taifur20/Edge-Bird/README.md

# Edge-Bird
This design is a step toward environmental conservation<br><br>
*Field deployment of the Edge-Bird.*
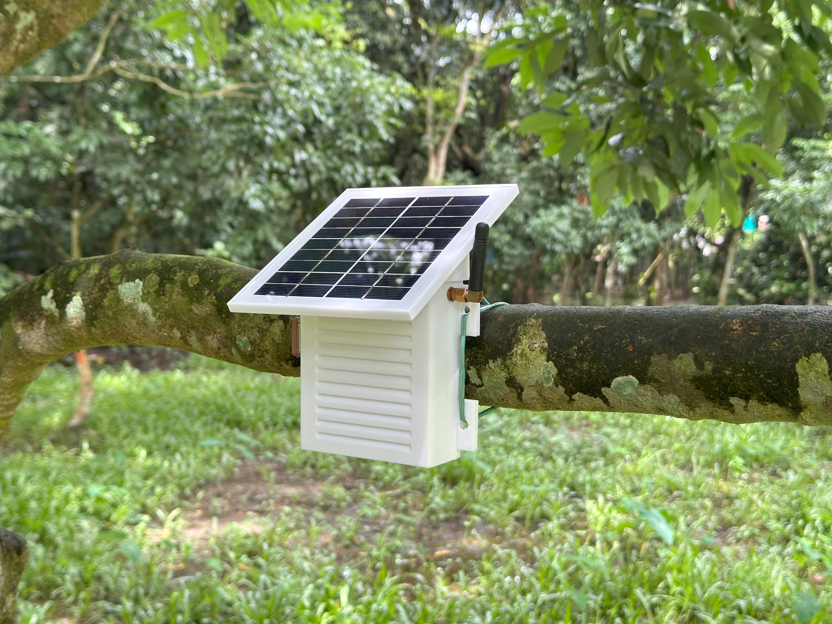
[picture p1: deployment_img1.jpg]
Deployment of the Edge-Bird

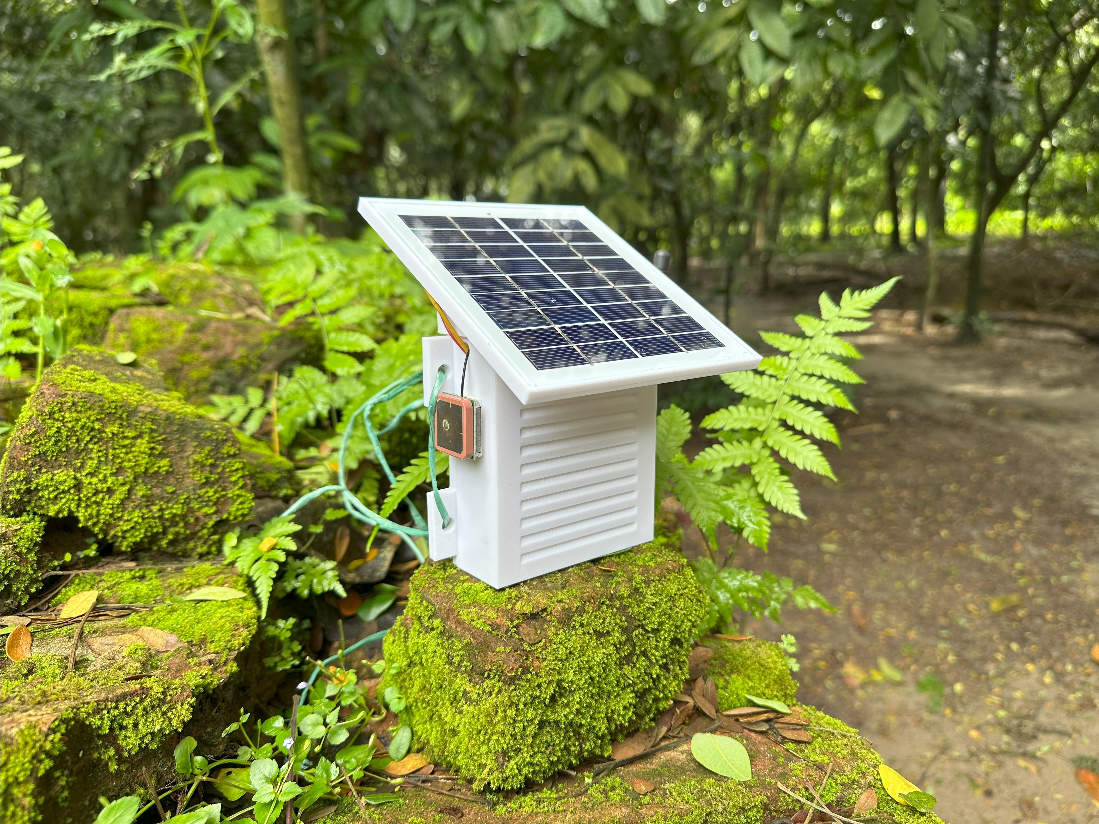
[picture p2: deployment_img2.jpg]
Deployment of the Edge-Bird

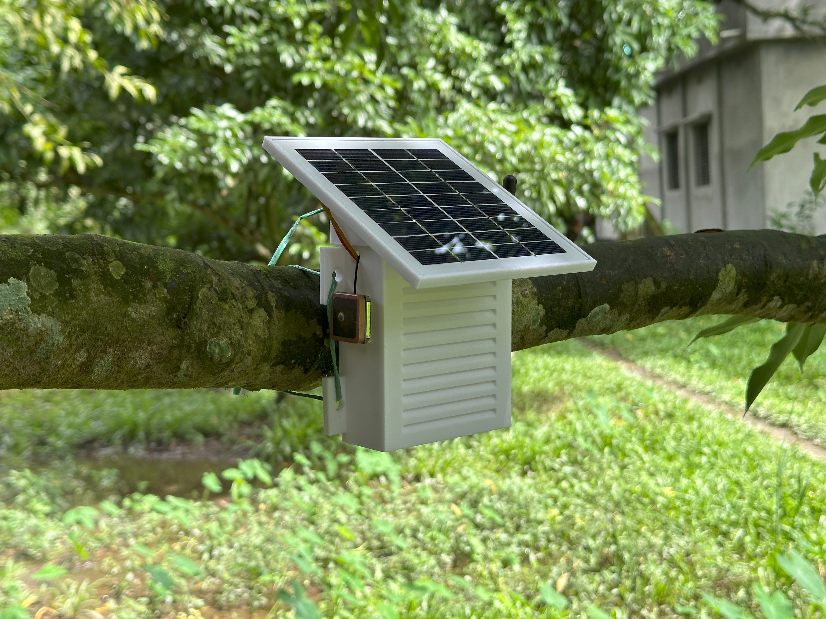
[picture p3: deployment_img3.jpg]
Deployment of the Edge-Bird
