taifur20/Edge-Bird/3D Files/panel_mount.jpg

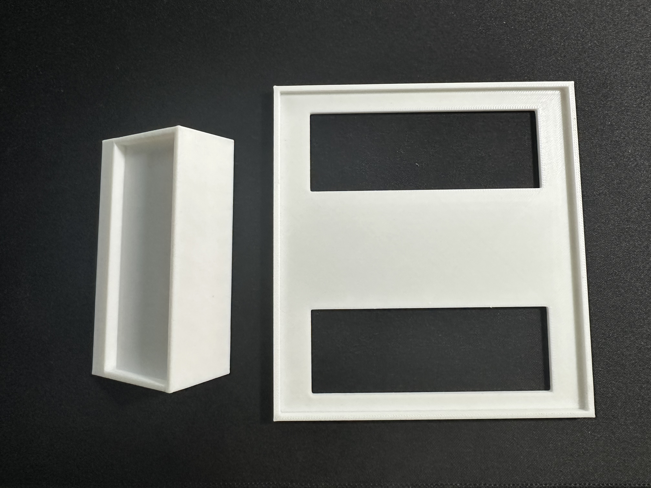
3D Files/panel_mount.jpg
