taifur20/Edge-Bird/full_inference_with_sd_logging/serial_monitor_data.jpg

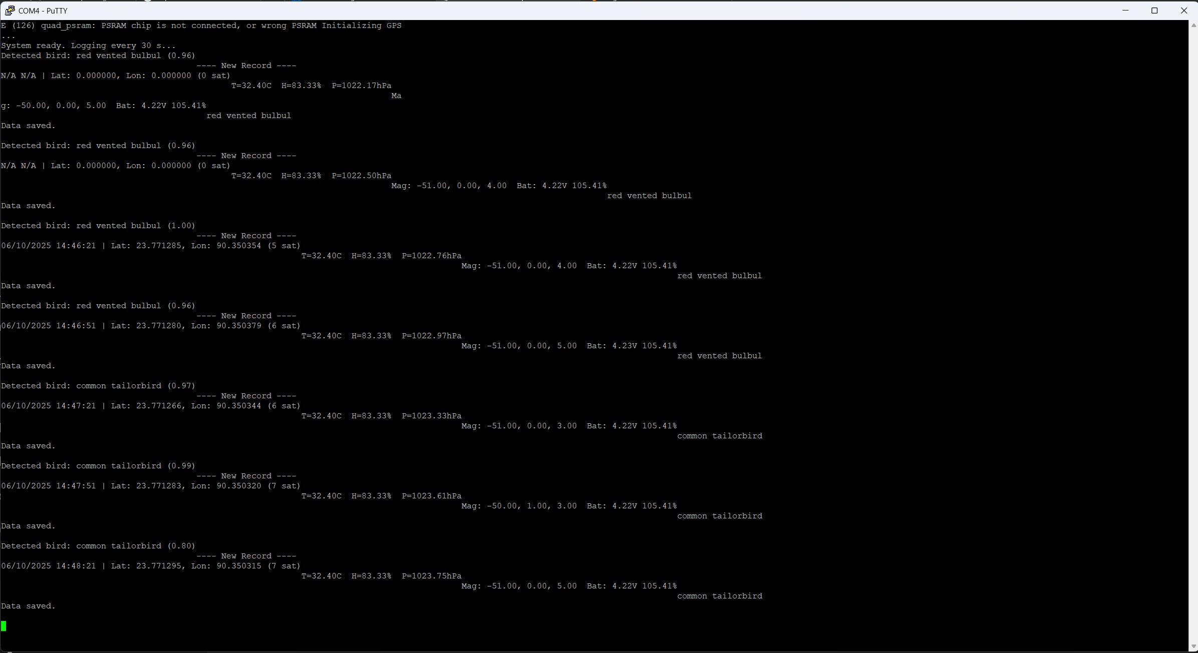
full_inference_with_sd_logging/serial_monitor_data.jpg
