taifur20/Edge-Bird/hardware/2d-view.png

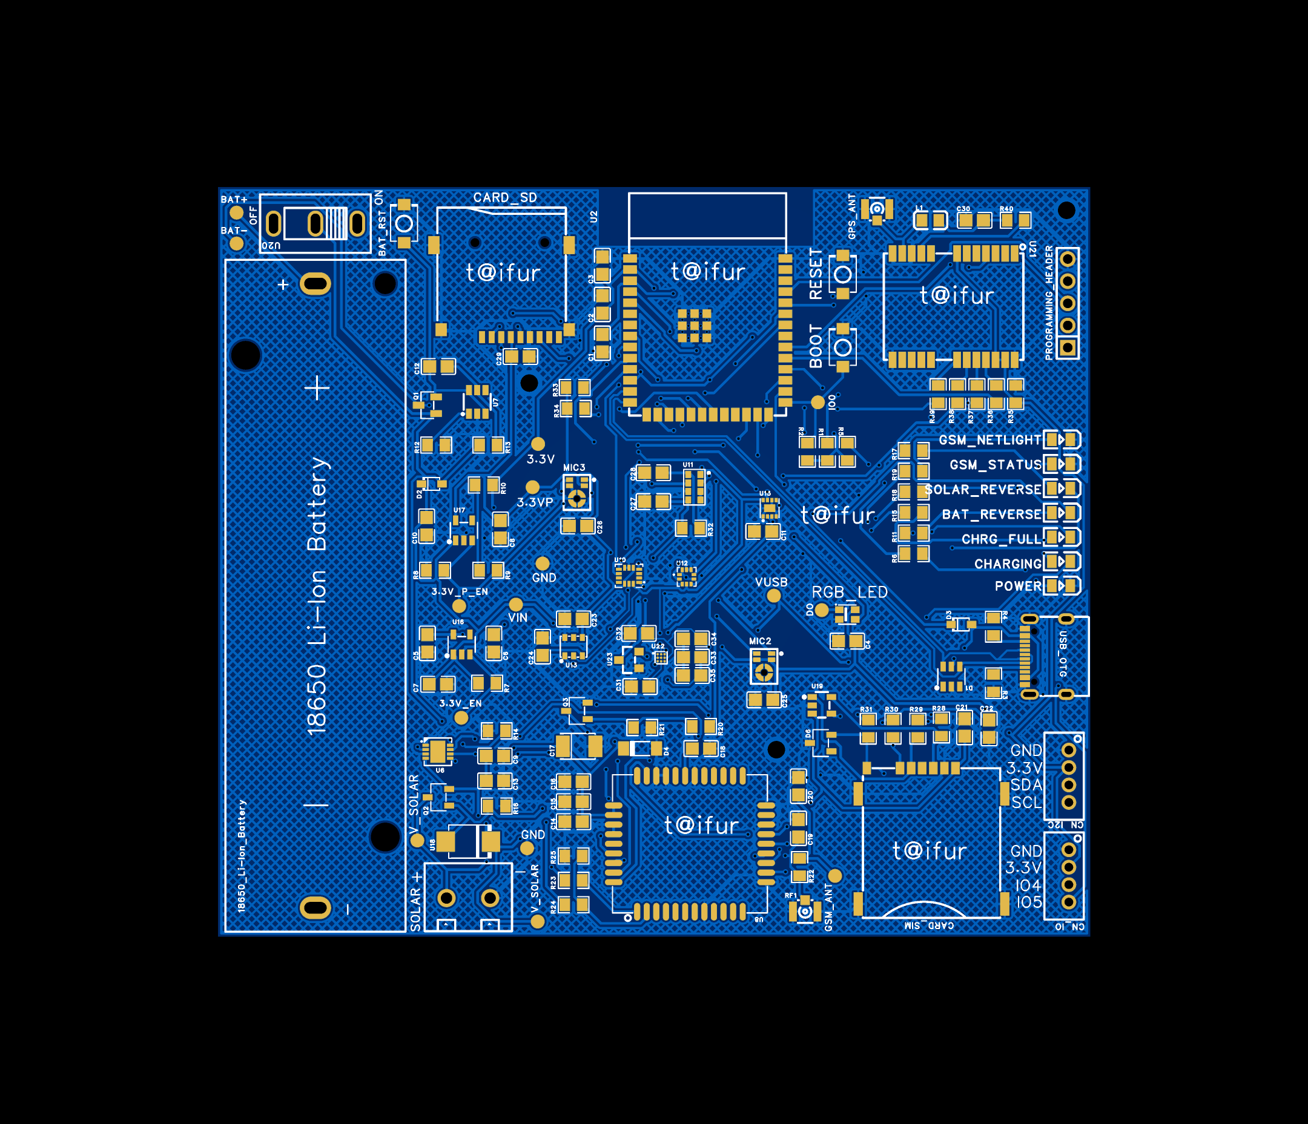
hardware/2d-view.png
