taifur20/Edge-Bird/hardware/3d-view bottom.png

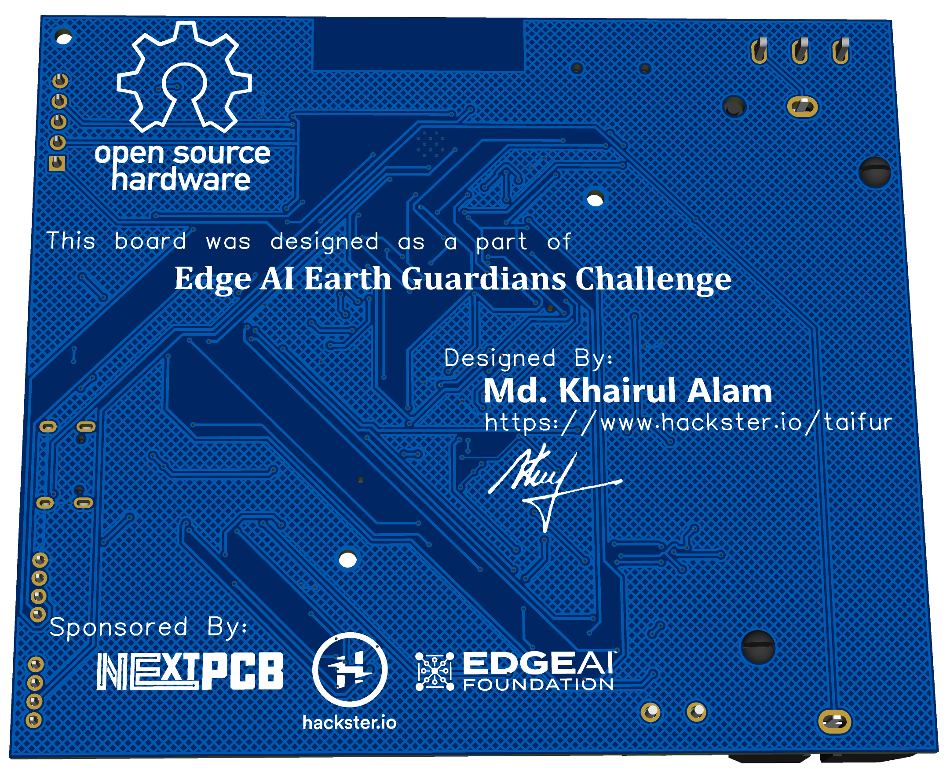
hardware/3d-view bottom.png
