taifur20/Edge-Bird/hardware/3d-view-top.png

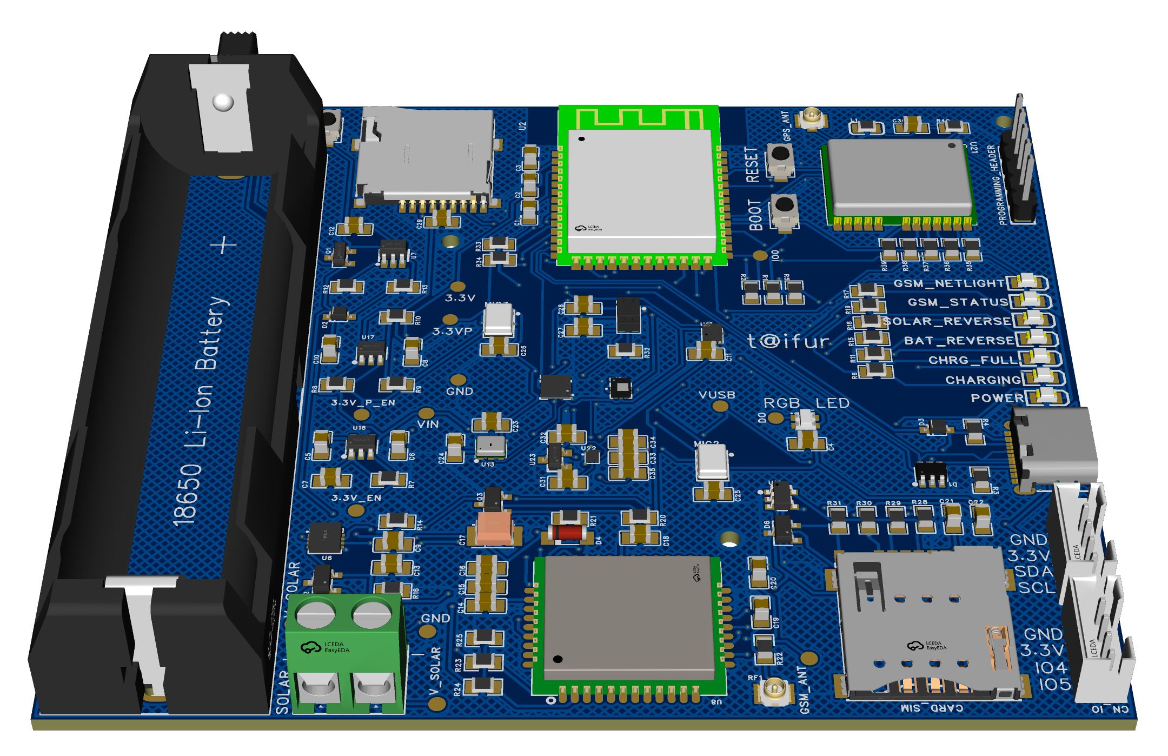
hardware/3d-view-top.png
