taifur20/Edge-Bird/hardware/board_in_hand.jpg

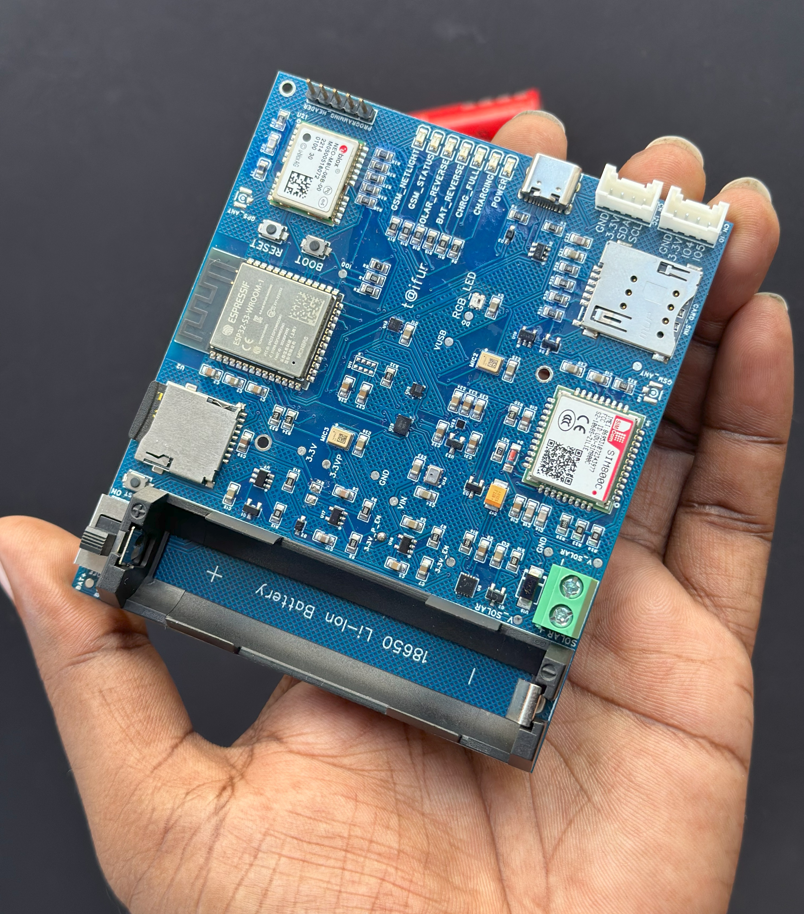
hardware/board_in_hand.jpg
