taifur20/Edge-Bird/sample code/gps_sample/gps-data.jpg

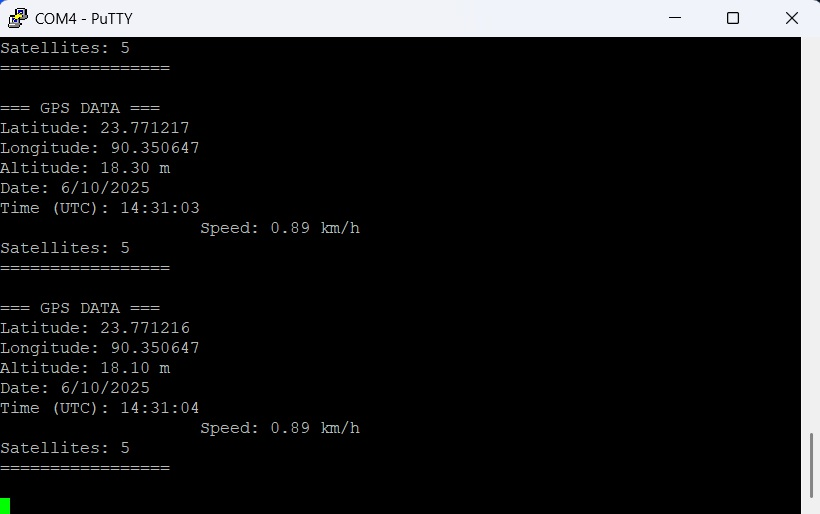
sample code/gps_sample/gps-data.jpg
