taifur20/Edge-Bird/hardware/BOM_Details.xlsx

BOM File: |  | BOMBoard1PCB120250813BE94345AA11 |  |  |  |  |  |  | Order ID： | B-E94345AA1 |  |  |  | Quote Time: | 2025/08/18 13:44:17
Purchase Quantity： |  | 1 pcs |  |  |  |  |  |  | BOM Total ($)： | 97.97
Inquiry |  |  |  |  |  |  |  |  | HQNextPCB-Quotation
S/N | Designator* | Quantity* | Manufacturer Part Number* | Manufacturer | Package /Footprint | Description | Procurement Type | Customer Note | Quote MPN | Quote Brand | Package /Footprint | Plan Qty | Overage Amount | Quote Qty | Unit Price($) | Subtotal($) | Lead Time | Question from HQ NextPCB | Customer Reply
1 | 3.3V_EN,3.3V_P_EN,BAT+,BAT-,DO,GSM_ANT,IO0,V_SOLAR | 8 |  |  | Test-Point-0.5mm |  | DNP |  |  |  |  | 8 | 0 | 8 | 0 | 0
2 | 18650_Li-Ion_Battery | 1 | BH-18650-A6AJ003 | MYOUNG(美阳) | BAT-TH_BH-18650-A5BJ003 |  |  |  | BH-18650-A6AJ003 | MYOUNG(美阳) |  | 1 | 1 | 2 | 1.28968 | 2.58 | 4-7 Days
3 | BAT_REVERSE,CHARGING,GSM_NETLIGHT,GSM_STATUS,SOLAR_REVERSE | 5 | NCD0805R1 | 国星光电 | LED0805-R-RD |  |  |  | NCD0805R1 | NATIONSTAR | 0805 | 5 | 40 | 50 | 0.01025 | 0.51 | In Stock
4 | BAT_RST,BOOT,RESET | 3 | TS-1088-AR02016 | XUNPU(讯普) | SW-SMD_L3.9-W3.0-P4.45 |  |  |  | TS-1088-AR02016 | XUNPU | SW2_4X2.9MM_SM | 3 | 5 | 10 | 0.03846 | 0.38 | In Stock
5 | C1,C5 | 2 | CL21B105KOFNNNE | SAMSUNG(三星) | C0805 | 1uF |  |  | CL21B105KOFNNNE | Samsung | 0805 | 2 | 40 | 50 | 0.00931 | 0.47 | In Stock
6 | C2 | 1 | CC0805KKX5R5BB475 | YAGEO(国巨) | C0805 | 4.7uF |  |  | CC0805KKX5R5BB475 | Yageo | 0805 | 1 | 15 | 16 | 0.08507 | 1.36 | 4-7 Days
7 | C3 | 1 | CL21A226MQQNNNE | SAMSUNG(三星) | C0805 | 22uF |  |  | CL21A226MQQNNNE | Samsung | 0805 | 1 | 40 | 41 | 0.0096 | 0.39 | In Stock
8 | C4,C6,C11,C12,C13,C23,C24,C25,C26 | 9 | CC0805KRX7R5BB104 | YAGEO(国巨) | C0805 | 100nF |  |  | CC0805KRX7R5BB104 | YAGEO | 0805 | 9 | 15 | 24 | 0.08139 | 1.95 | 7-18 Days
9 | C7,C10 | 2 | CL21B225KOFNNNE | SAMSUNG(三星) | C0805 | 2.2uF |  |  | CL21B225KOFNNNE | Samsung | 0805 | 2 | 40 | 42 | 0.01837 | 0.77 | In Stock
10 | C8 | 1 | CL21A106KPFNNNE | SAMSUNG(三星) | C0805 | 10uF |  |  | CL21A106KPFNNNE | Samsung | 0805 | 1 | 40 | 41 | 0.00664 | 0.27 | In Stock
11 | C9 | 1 | CL21A106KOQNNNE | SAMSUNG(三星) | C0805 | 10uF |  |  | CL21A106KOQNNNE | Samsung | 0805 | 1 | 40 | 50 | 0.00687 | 0.34 | In Stock
12 | C14 | 1 | 0805CG100J500NT | FH(风华) | C0805 | 10pF |  |  | 0805CG100J500NT | FH | 0805 | 1 | 40 | 50 | 0.00451 | 0.23 | In Stock
13 | C15 | 1 | 0805CG330J500NT | FH(风华) | C0805 | 33pF |  |  | 0805CG330J500NT | FH | 0805 | 1 | 40 | 50 | 0.00459 | 0.23 | In Stock
14 | C16,C27,C28 | 3 | CL21B105KBFNNNE | SAMSUNG(三星) | C0805 | 1uF |  |  | CL21B105KBFNNNE | Samsung | 0805 | 3 | 40 | 43 | 0.00723 | 0.31 | In Stock
15 | C17 | 1 | TAJB107K006RNJ | Kyocera AVX | CASE-B_3528 | 100uF |  |  | TAJB107K006RNJ | AVX | B3528-21 | 1 | 3 | 5 | 0.1577 | 0.79 | In Stock
16 | C18 | 1 | CL21A475KAQNNNE | SAMSUNG(三星) | C0805 | 4.7uF |  |  | CL21A475KAQNNNE | Samsung | 0805 | 1 | 40 | 41 | 0.00905 | 0.37 | In Stock
17 | C19,C20,C21 | 3 | CC0805KRX7R9BB104 | YAGEO(国巨) | C0805 | 100nF |  |  | CC0805KRX7R9BB104 | Yageo | 0805 | 3 | 40 | 50 | 0.00314 | 0.16 | In Stock
18 | C22 | 1 | CL21C220JBANNNC | SAMSUNG(三星) | C0805 | 22pF |  |  | CL21C220JBANNNC | Samsung | 0805 | 1 | 40 | 50 | 0.00866 | 0.43 | In Stock
19 | C29 | 1 | CL21A106KAYNNNE | SAMSUNG(三星) | C0805 | 10uF |  |  | CL21A106KAYNNNE | Samsung | 0805 | 1 | 40 | 50 | 0.0083 | 0.42 | In Stock
20 | C30 | 1 | CC0805JRNPO9BN470 | YAGEO(国巨) | C0805 | 47pF |  |  | CC0805JRNPO9BN470 | Yageo | 0805 | 1 | 40 | 50 | 0.00559 | 0.28 | In Stock
21 | C31,C32,C33 | 3 | CL21B225KAFNNNE | SAMSUNG(三星) | C0805 | 2.2uF |  |  | CL21B225KAFNNNE | Samsung | 0805 | 3 | 40 | 43 | 0.0095 | 0.41 | In Stock
22 | C34,C35 | 2 | CL21B104KCFNNNE | SAMSUNG(三星) | C0805 | 100nF |  |  | CL21B104KCFNNNE | Samsung | 0805 | 2 | 40 | 42 | 0.00442 | 0.19 | In Stock
23 | CARD_SD | 1 | TF-01A | 韩国韩荣 | TF-SMD_TF-01A |  |  |  | TF-01A | Yuandi | SMD | 1 | 10 | 11 | 0.08689 | 0.96 | In Stock
24 | CARD_SIM | 1 | C7092-03 | MUP(德海威) | SIM-SMD_C7092-03 |  |  |  | C7092-03 | MUP(德海威) | SMD | 1 | 1 | 2 | 0.71782 | 1.44 | 4-7 Days
25 | CHRG_FULL,POWER | 2 | NCD0805G1 | 国星光电 | LED0805-R-RD |  |  |  | NCD0805G1 | NATIONSTAR | 0805 | 2 | 40 | 42 | 0.01957 | 0.82 | In Stock
26 | CN_I2C,CN_IO | 2 | B4B-PH-K-S(LF)(SN) | JST | CONN-TH_B4B-PH-K-S |  | DNP |  |  |  |  | 2 | 0 | 2 | 0 | 0
27 | D1 | 1 | DT1042-04SO-7 | DIODES(美台) | SOT-26_L3.0-W1.6-P0.95-LS2.8-BL |  |  |  | DT1042-04SO-7 | DIODES | SOT23-6 | 1 | 10 | 11 | 0.05801 | 0.64 | In Stock
28 | D2,D3 | 2 | BAT60A | Slkor(萨科微) | SOD-323_L1.8-W1.3-LS2.5-RD |  |  |  | BAT60A | Slkor(萨科微) | SOD-323 | 2 | 30 | 32 | 0.04131 | 1.32 | 4-7 Days
29 | D4 | 1 | ZMM5V1PF-M | ST(先科) | LL-34_L3.5-W1.5-R-RD |  |  |  | ZMM5V1PF-M | ST(先科) | LL-34 | 1 | 15 | 50 | 0.01481 | 0.74 | In Stock
30 | D6 | 1 | ESDA6V1L | BORN(伯恩半导体) | SOT-23-3_L2.9-W1.6-P1.90-LS2.8-BR |  |  |  | ESDA6V1L | BORN(伯恩半导体) | SOT-23 | 1 | 15 | 16 | 0.01283 | 0.21 | In Stock
31 | GPS_ANT,RF1 | 2 | U.FL-R-SMT(01) | HRS(广濑) | ANT-SMD_UFL-R-SMT01 |  |  |  | U.FL-R-SMT(01) | HRS(广濑) | RF-CONN-2.6X2.6MM_SM | 2 | 1 | 3 | 1.5886 | 4.77 | 3-5 Days
32 | L1 | 1 | BLM21PG300SN1D | muRata(村田) | L0805 |  |  |  | BLM21PG300SN1D | Murata | 0805 | 1 | 40 | 50 | 0.01528 | 0.76 | In Stock
33 | MIC2,MIC3 | 2 | IM69D130V01 | Infineon(英飞凌) | MIC-SMD_5P-L4.0-W3.0-P0.70-TR_IM69D130V01 |  |  |  | IM69D130V01 | Infineon |  | 2 | 1 | 3 | 4.04 | 12.12 | 7-18 Days
34 | PROGRAMMING_HEADER | 1 | PROGRAMMING | XFCN(兴飞) | HDR-TH_5P-P2.54-V-M |  | DNP |  |  |  |  | 1 | 0 | 1 | 0 | 0
35 | Q1 | 1 | AO3400 | ALJ(龙晶微) | SOT-23-3_L2.9-W1.3-P1.90-LS2.4-BR |  |  |  | AO3400 | ALJ(龙晶微) | SOT-23 | 1 | 15 | 20 | 0.01822 | 0.36 | In Stock
36 | Q2 | 1 | SI2301 | KUU | SOT-23-3_L2.9-W1.6-P1.90-LS2.8-BR |  |  |  | SI2301 | KUU | SOT-23 | 1 | 15 | 50 | 0.01101 | 0.55 | In Stock
37 | Q3 | 1 | BC848C | Hottech(合科泰) | SOT-23-3_L2.9-W1.6-P1.90-LS2.8-BR |  |  |  | BC848C | Hottech(合科泰) | SOT-23 | 1 | 15 | 24 | 0.0099 | 0.24 | In Stock
38 | R1,R2,R9,R16 | 4 | 0805W8F1002T5E | UNI-ROYAL(厚声) | R0805 | 10kΩ |  |  | 0805W8F1002T5E | Uniohm | 0805 | 4 | 40 | 100 | 0.00106 | 0.11 | In Stock
39 | R3,R4 | 2 | 0805W8F5101T5E | UNI-ROYAL(厚声) | R0805 | 5.1kΩ |  |  | 0805W8F5101T5E | Uniohm | 0805 | 2 | 40 | 100 | 0.00116 | 0.12 | In Stock
40 | R5,R10 | 2 | 0805W8F0000T5E | UNI-ROYAL(厚声) | R0805 | 0Ω |  |  | 0805W8F0000T5E | Uniohm | 0805 | 2 | 40 | 100 | 0.00117 | 0.12 | In Stock
41 | R6,R15,R20,R31,R33,R34 | 6 | 0805W8F4701T5E | UNI-ROYAL(厚声) | R0805 | 4.7kΩ |  |  | 0805W8F4701T5E | Uniohm | 0805 | 6 | 40 | 100 | 0.00109 | 0.11 | In Stock
42 | R7,R8,R35 | 3 | 0805W8F1003T5E | UNI-ROYAL(厚声) | R0805 | 100kΩ |  |  | 0805W8F1003T5E | Uniohm | 0805 | 3 | 40 | 100 | 0.00109 | 0.11 | In Stock
43 | R11,R12,R17,R18,R19,R23,R24 | 7 | 0805W8F1001T5E | UNI-ROYAL(厚声) | R0805 | 1kΩ |  |  | 0805W8F1001T5E | Uniohm | 0805 | 7 | 40 | 100 | 0.00158 | 0.16 | In Stock
44 | R13 | 1 | 0805W8F1000T5E | UNI-ROYAL(厚声) | R0805 | 100Ω |  |  | 0805W8F1000T5E | Uniohm | 0805 | 1 | 40 | 100 | 0.00168 | 0.17 | In Stock
45 | R14 | 1 | 0805W8F2001T5E | UNI-ROYAL(厚声) | R0805 | 2kΩ |  |  | 0805W8F2001T5E | Uniohm | 0805 | 1 | 40 | 100 | 0.00168 | 0.17 | In Stock
46 | R21 | 1 | FRC0805J473 TS | FOJAN(富捷) | R0805 | 47kΩ |  |  | FRC0805J473 TS | FOJAN | 0805 | 1 | 40 | 100 | 0.00082 | 0.08 | In Stock
47 | R22 | 1 | 0805W8F1503T5E | UNI-ROYAL(厚声) | R0805 | 150kΩ |  |  | 0805W8F1503T5E | Uniohm | 0805 | 1 | 40 | 100 | 0.00173 | 0.17 | In Stock
48 | R25 | 1 | 0805W8F5601T5E | UNI-ROYAL(厚声) | R0805 | 5.6kΩ |  |  | 0805W8F5601T5E | Uniohm | 0805 | 1 | 40 | 100 | 0.00173 | 0.17 | In Stock
49 | R28,R29,R30 | 3 | 0805W8F510JT5E | UNI-ROYAL(厚声) | R0805 | 51Ω |  |  | 0805W8F510JT5E | Uniohm | 0805 | 3 | 40 | 100 | 0.00177 | 0.18 | In Stock
50 | R32 | 1 | 0805W8F220JT5E | UNI-ROYAL(厚声) | R0805 | 22Ω |  |  | 0805W8F220JT5E | Uniohm | 0805 | 1 | 40 | 100 | 0.00177 | 0.18 | In Stock
51 | R36,R37,R38,R39 | 4 | 0805W8F330JT5E | UNI-ROYAL(厚声) | R0805 | 33Ω |  |  | 0805W8F330JT5E | Uniohm | 0805 | 4 | 40 | 100 | 0.00173 | 0.17 | In Stock
52 | R40 | 1 | 0805W8F100JT5E | UNI-ROYAL(厚声) | R0805_NEW | 10Ω |  |  | 0805W8F100JT5E | Uniohm | 0805 | 1 | 40 | 100 | 0.00105 | 0.11 | In Stock
53 | RGB_LED | 1 | WS2812B-2020 | worldsemi | LED-SMD_4P-L2.0-W2.0-TL_WS2812B-2020 |  |  |  | WS2812B-2020 | WORLDsemi | LED_2.2X2MM_SM | 1 | 10 | 11 | 0.06423 | 0.71 | In Stock
54 | SOLAR | 1 | WJ126V-5.0-2P | KANGNEX(康奈克斯电气) | CONN-TH_WJ126V-5.0-2P |  |  |  | WJ126V-5.0-2P | Kangnex | TERMINAL_10X7.8MM_TM | 1 | 5 | 6 | 0.06154 | 0.37 | In Stock
55 | U2 | 1 | ESP32-S3-WROOM-1-N8 | ESPRESSIF(乐鑫) | WIFIM-SMD_ESP32-S3-WROOM-1-N8 | 2.4GHz |  |  | ESP32-S3-WROOM-1-N8 | Espressif | MODULE-38P_18X25.5MM_SM | 1 | 0 | 1 | 3.89756 | 3.9 | In Stock
56 | U6 | 1 | CN3165 | CONSONANCE(上海如韵) | DFN-8_L3.0-W3.0-P0.50-BL-EP |  |  |  | CN3165 | CONSONANCE(上海如韵) | DFN8_3.1X3.1MM | 1 | 3 | 4 | 0.31543 | 1.26 | 4-7 Days
57 | U7 | 1 | DW06D/J | FM(富满) | SOT-23-6_L2.9-W1.6-P0.95-LS2.8-BR |  |  |  | DW06D/J | FM(富满) | SOT23-6 | 1 | 10 | 11 | 0.05798 | 0.64 | 4-7 Days
58 | U8 | 1 | SIM800C | SIMCOM(芯讯通无线科技) | GSM-SMD_42P-L17.6-W15.7-P1.10-TL |  |  |  | SIM800C | SIMCOM(芯讯通无线科技) | MODULE-17.6×15.7MM_SM | 1 | 0 | 1 | 7.60363 | 7.6 | 4-7 Days
59 | U10 | 1 | BMI270 | Bosch(博世) | LGA-14_L3.0-W2.5-P0.50-BR |  |  |  | BMI270 | Bosch | LGA14_3X2.5MM | 1 | 0 | 1 | 1.00806 | 1.01 | In Stock
60 | U11 | 1 | APDS-9960 | Broadcom(博通) | SENSORS-SMD_APDS-9960 |  | DNP |  |  |  |  | 1 | 0 | 1 | 0 | 0
61 | U12 | 1 | LPS22HBTR | ST(意法半导体) | HLGA-10L_LPS22HBTR |  |  |  | LPS22HBTR | ST | HLGA-10L_2X2MM | 1 | 0 | 1 | 3.0771 | 3.08 | In Stock
62 | U13 | 1 | HS3003 | RENESAS(瑞萨)/IDT | LGA-6_L3.0-W2.4-P1.00-BL |  |  |  | HS3003 | RENESAS | LGA6_3X2.4MM | 1 | 0 | 1 | 1.96525 | 1.97 | 4-7 Days
63 | U15 | 1 | MAX17048G+T10 | ADI(亚德诺)/MAXIM(美信) | TDFN-8_L2.0-W2.0-P0.50-BL-EP1.2 |  |  |  | MAX17048G+T10 | ADI | WFDFN8_EP | 1 | 0 | 1 | 3.66174 | 3.66 | In Stock
64 | U16,U17 | 2 | RT9080-33GJ5 | RICHTEK(立锜) | TSOT-23-5_L2.9-W1.6-P0.95-LS2.8-BL |  |  |  | RT9080-33GJ5 | Richtek | TSOT23-5 | 2 | 5 | 7 | 0.09781 | 0.68 | In Stock
65 | U18 | 1 | SK34 | CJ(江苏长电/长晶) | SMB_L4.3-W3.6-LS5.4-RD |  |  |  | SK34 | CJ(江苏长电/长晶) | SMA(DO-214AC) | 1 | 5 | 20 | 0.02528 | 0.51 | In Stock
66 | U19 | 1 | ESDA6V1SC5 | ST(意法半导体) | SOT-23-5_L2.9-W1.6-P0.95-LS2.8-BR |  |  |  | ESDA6V1SC5 | ST(意法半导体) | SC-74A | 1 | 5 | 6 | 0.2078 | 1.25 | 4-7 Days
67 | U20 | 1 | SS12D10G5 | SHOU HAN(首韩) | SW-TH_SHOU-HAN_SS12D10G4 |  |  |  | SS12D10G5 | SHOU HAN(首韩) | SW3_12.7X6.6MM_TM | 1 | 3 | 4 | 0.1474 | 0.59 | 4-7 Days
68 | U21 | 1 | NEO-M8U-06B | U-BLOX | GPSM-SMD_24P-L16.0-W12.2-P1.10-TL |  |  |  | NEO-M8U-06B | U-BLOX | SMD24模块 | 1 | 0 | 1 | 27.02976 | 27.03 | 4-7 Days
69 | U22 | 1 | BMM350 | Bosch(博世) | WLCSP-9_L1.3-W1.3-R3-C3-P0.40-TL |  |  |  | BMM350 | Bosch(博世) | WLCSP9 | 1 | 0 | 1 | 2.48414 | 2.48 | 4-7 Days
70 | U23 | 1 | ME6206A18XG | MICRONE(南京微盟) | SOT-23_L2.9-W1.3-P1.90-LS2.4-BR |  |  |  | ME6206A18XG | MICRONE(南京微盟) | SOT-23 | 1 | 15 | 20 | 0.03933 | 0.79 | 4-7 Days
71 | USB_OTG | 1 | TYPE-C 16PIN 2MD(073) | SHOU HAN(首韩) | USB-C-SMD_TYPE-C-6PIN-2MD-073 |  |  |  | TYPE-C 16PIN 2MD(073) | SHOU HAN | USB16-TYPEC_8.94X7.35MM_SM | 1 | 10 | 11 | 0.04923 | 0.54 | In Stock
