taifur20/Edge-Bird/3D Files/Bird-Edge-top.stl

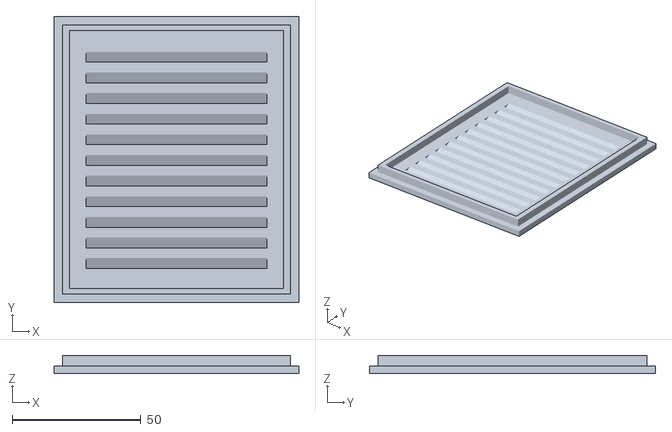
[picture p12: CAD file, 2025-10-01]
3D Files/Bird-Edge-top.stl
95.0 x 111.0 x 7.00
