taifur20/Edge-Bird/3D Files/Bird-Edge-base.stl

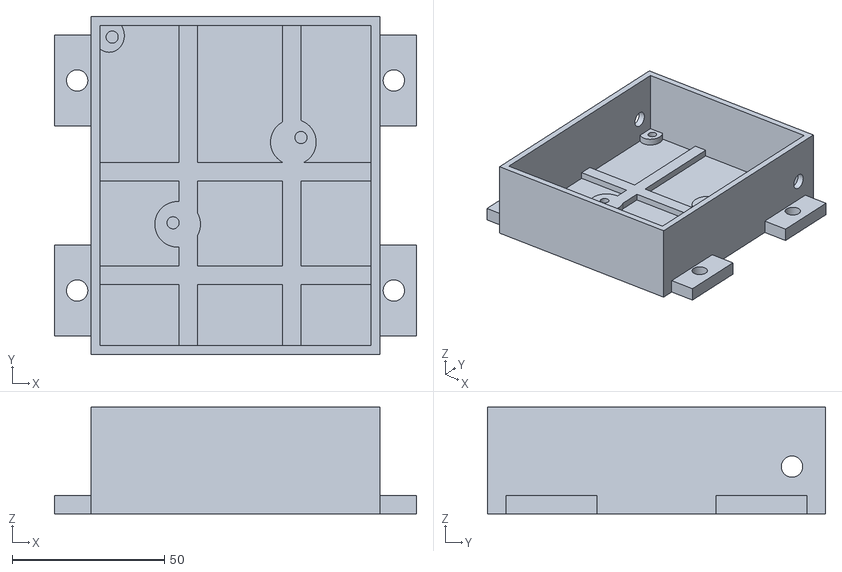
[picture p13: CAD file, 2025-10-01]
3D Files/Bird-Edge-base.stl
119.0 x 111.0 x 35.0
