taifur20/Edge-Bird/3D Files/solar_panel_base.stl

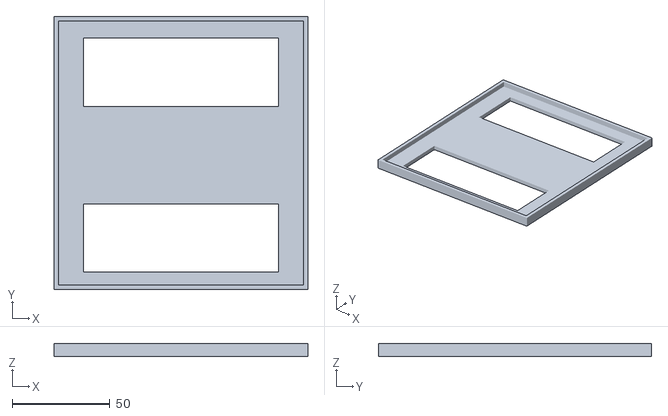
[picture p14: CAD file, 2025-10-01]
3D Files/solar_panel_base.stl
130.0 x 140.0 x 6.50
