taifur20/Edge-Bird/3D Files/panel_angle.stl

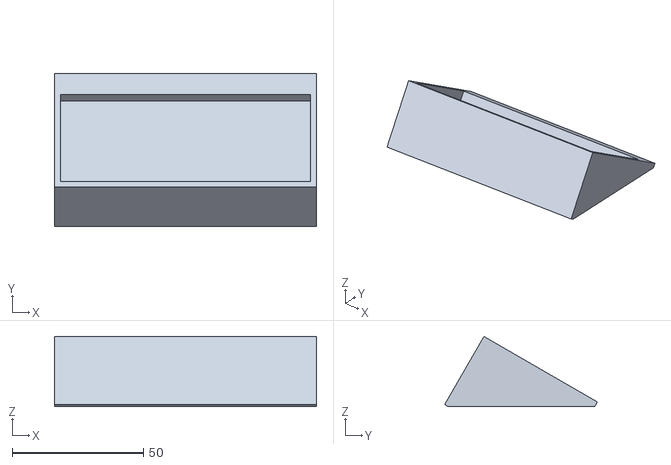
[picture p15: CAD file, 2025-10-01]
3D Files/panel_angle.stl
100.0 x 58.3 x 26.7
