taifur20/Edge-Bird/3D Files/simple_assembly.jpg

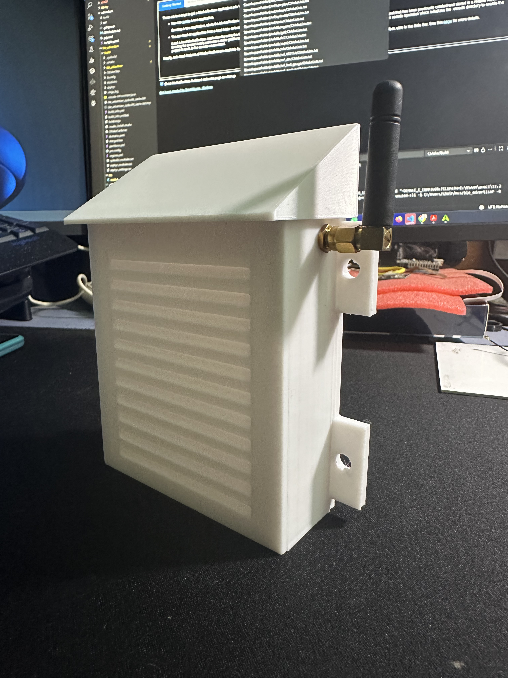
3D Files/simple_assembly.jpg
