taifur20/Edge-Bird/hardware/bird_edge_schematic.pdf

IO0 27 IO35 28 IO36 29 IO37 30 IO38 31 IO39 32 IO40 33 IO41 34 IO42 35 RXD0 36 TXD0 37 IO2 38 IO1 39 GND 40

ESP32 S3 WROOM-1 | USB OTG/PROGRAMMING

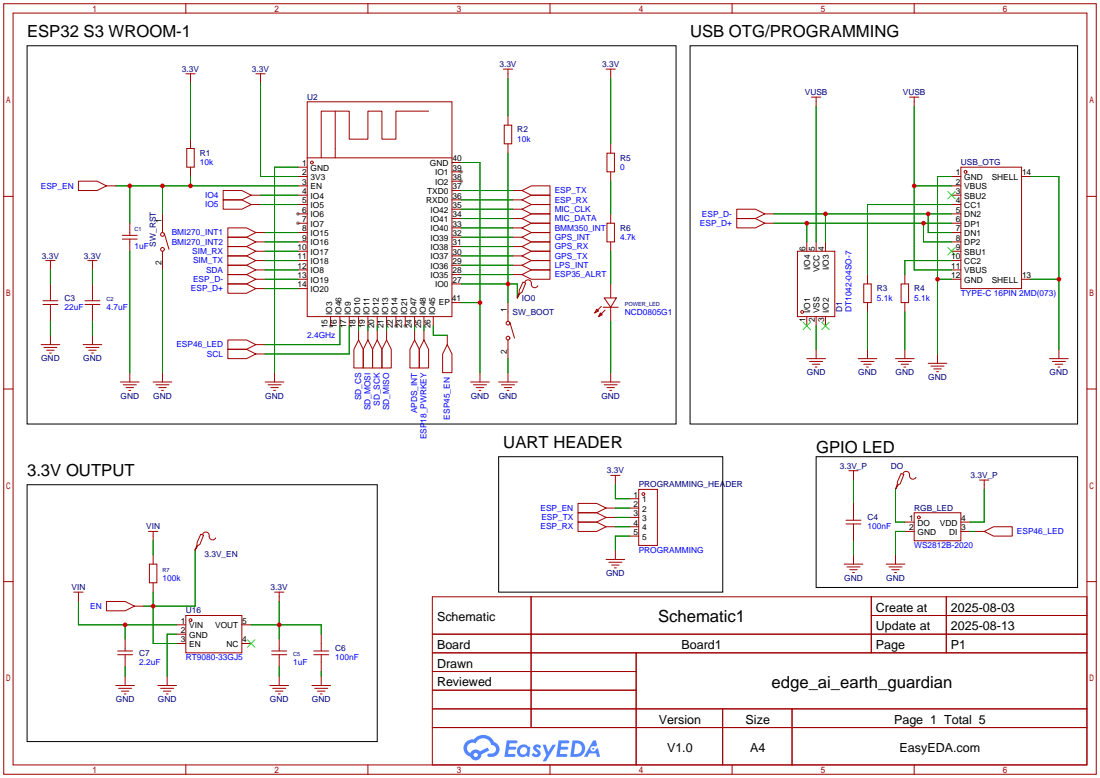
[picture p17: page 1]

Schematic | Schematic1 | Create at | 2025-08-03

Update at | 2025-08-13

Board | Board1 | Page | P1
Drawn | | edge_ai_earth_guardian
Reviewed

Version | Size | Page 1 Total 5
V1.0 | A4 | EasyEDA.com

# Fuel Gauge

# VOLTAGE SUPPLY FOR IO DEVICES

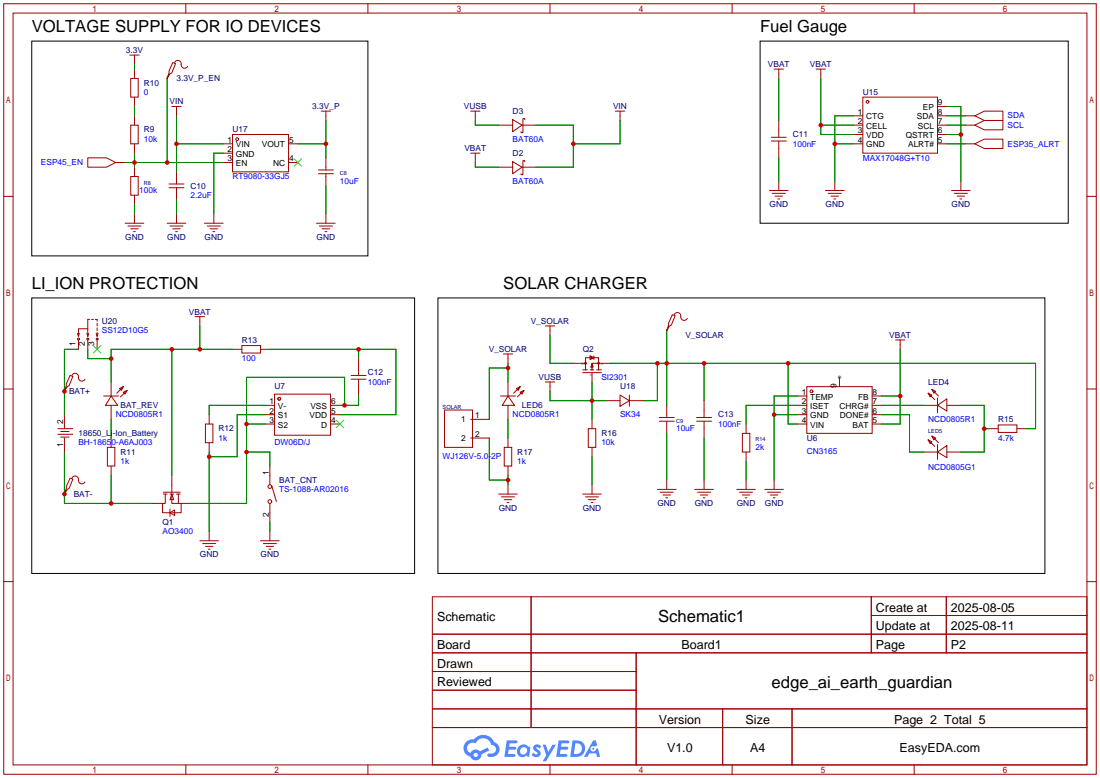
[picture p18: page 2]

Schematic | Schematic1 | Create at | 2025-08-05

Update at | 2025-08-11

Board | Board1 | Page | P2
Drawn | | edge_ai_earth_guardian
Reviewed

MICROPHONE | AMBIENT LIGHT, PROXIMITY | PRESSURE

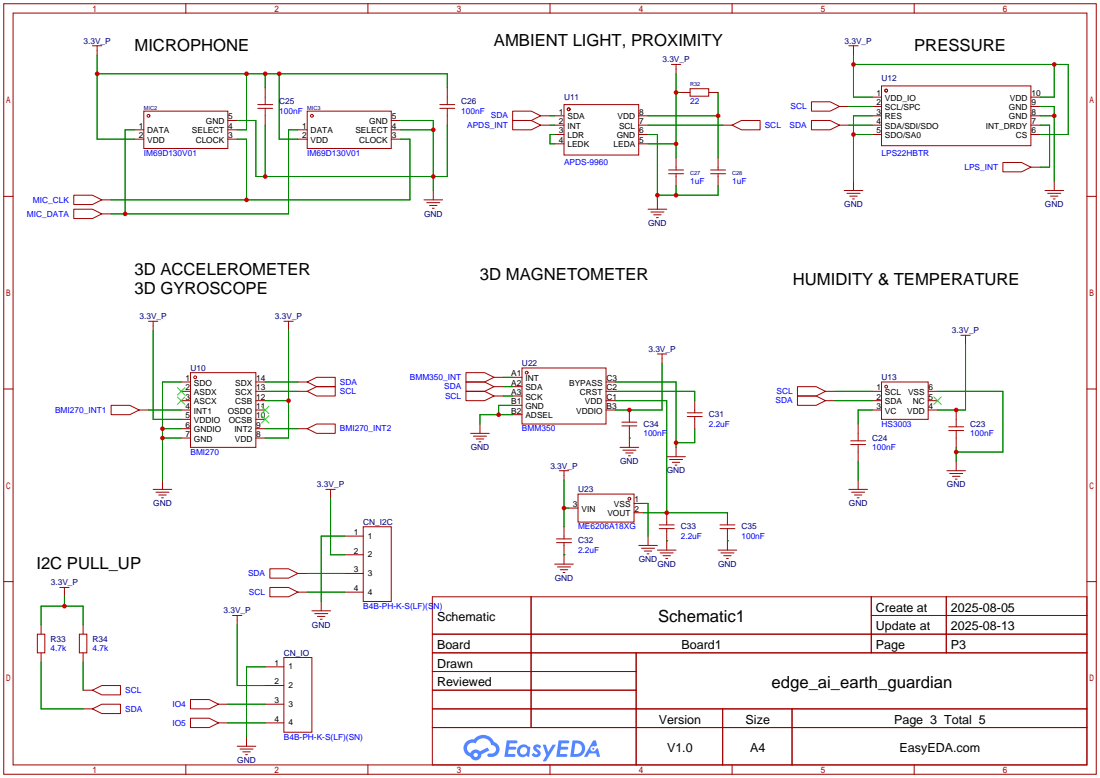
[picture p19: page 3]

ADSEL B2 GND B1 SCK A3 SDA A2 INT A1

OCSB 10 OSDO 11 CSB 12 SCX 13 SDX 14

Schematic | Schematic1 | Create at | 2025-08-05

Update at | 2025-08-13

Board | Board1 | Page | P3
Drawn | | edge_ai_earth_guardian
Reviewed

# SIM800C GSM

# SIM CONNECTOR

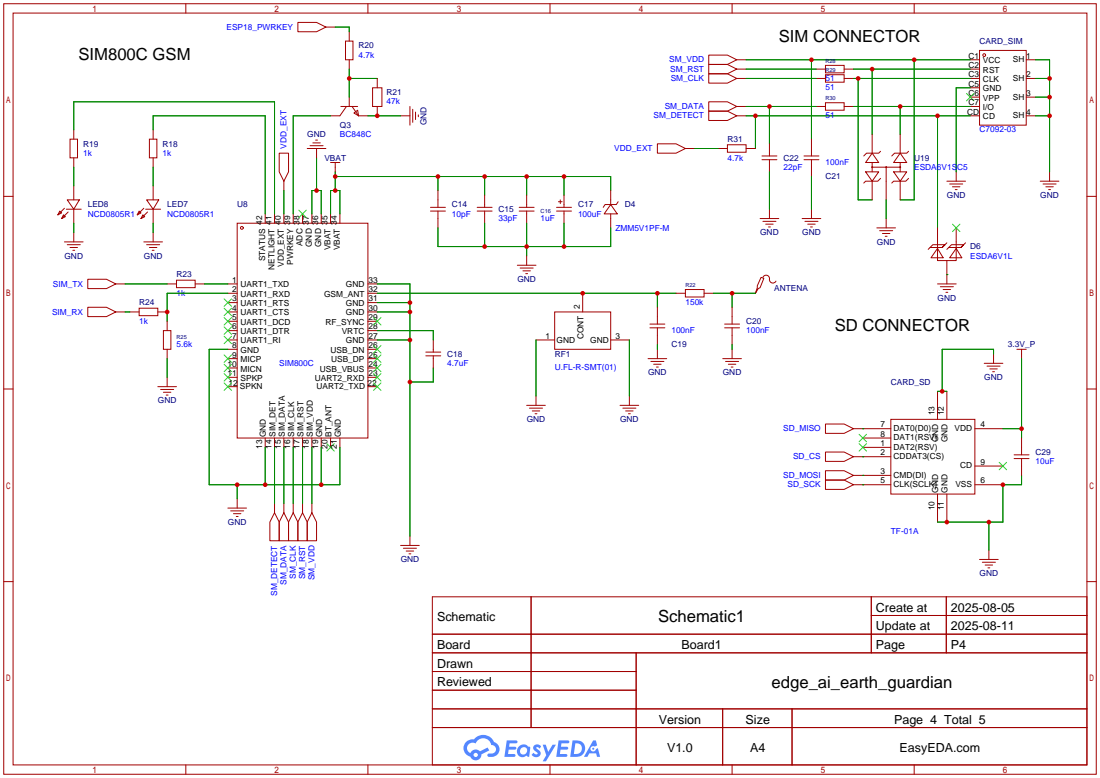
[picture p20: page 4]

CARD_SIM
VPP C6 GND C5 CLK C3 RST C2 VCC C1

UART2_RXD 23 USB_VBUS 24 USB_DP 25 USB_DN 26 GND 27 VRTC 28 RF_SYNC 29 GND 30 GND 31 GSM_ANT 32 GND 33 VBAT 34 VBAT 35 GND ³⁶

Schematic | Schematic1 | Create at | 2025-08-05

Update at | 2025-08-11

Board | Board1 | Page | P4
Drawn | | edge_ai_earth_guardian
Reviewed

# GPS Module Connection

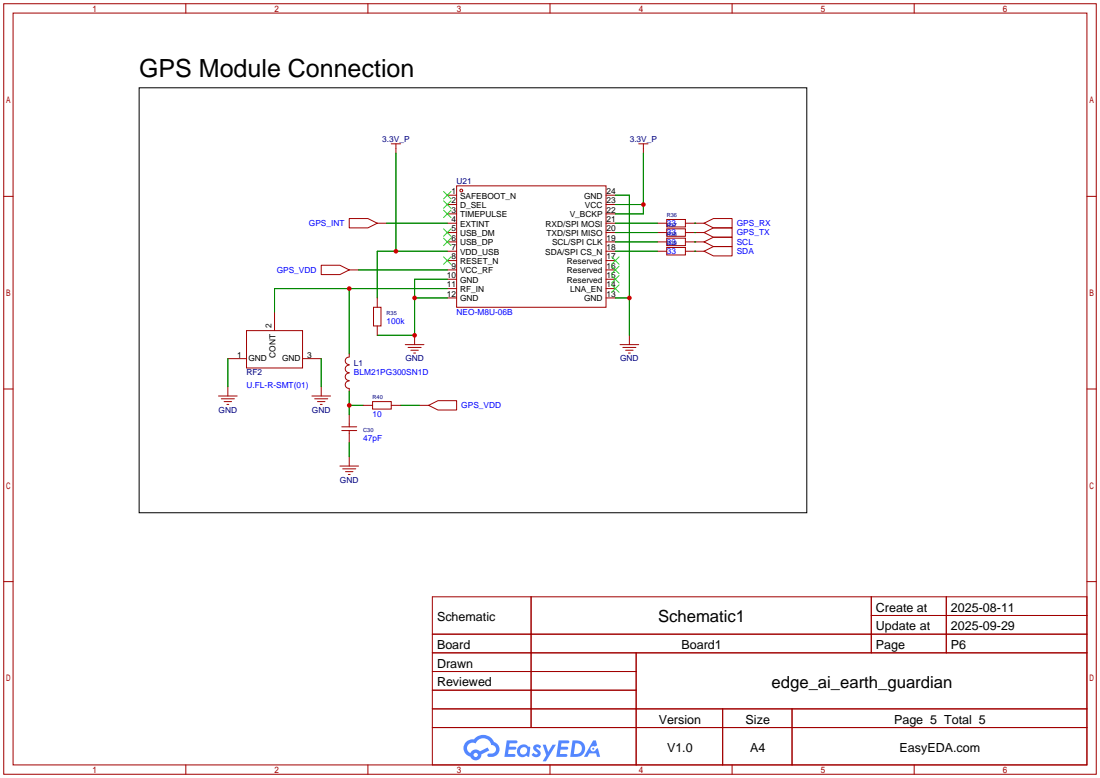
[picture p21: page 5]

Schematic | Schematic1 | Create at | 2025-08-11

Update at | 2025-09-29

Board | Board1 | Page | P6
Drawn | | edge_ai_earth_guardian
Reviewed
