taifur20/Edge-Bird/sample code/magnetometer_sensor/magnetometer_data/magnetometer_data.ino

 /*!
  * @file  getGeomagneticData.ino
  * @brief Get the geomagnetic data at 3 axis (x, y, z), get the compass degree
  * @n "Compass Degree", the angle formed when the needle rotates counterclockwise from the current position to the true north
  * @n Experimental phenomenon: serial print the geomagnetic data of x-axis, y-axis and z-axis and the compass degree
  * @copyright   Copyright (c) 2010 DFRobot Co.Ltd (http://www.dfrobot.com)
  * @license     The MIT License (MIT)
  * @author      [GDuang](yonglei.ren@dfrobot.com)
  * @version     V1.0.0
  * @date        2024-05-06
  * @url         https://github.com/DFRobot/DFRobot_BMM350
  */
 
#include "DFRobot_BMM350.h"


DFRobot_BMM350_I2C bmm350(&Wire, I2C_ADDRESS);

void setup() 
{
  pinMode(45, OUTPUT);
  digitalWrite(45, HIGH);
  Serial.begin(115200);
  while(!Serial);
  while(bmm350.begin()){
    Serial.println("bmm350 init failed, Please try again!");
    delay(1000);
  } Serial.println("bmm350 init success!");

  /**
   * Set sensor operation mode
   * opMode:
   *   eBmm350SuspendMode      // suspend mode: Suspend mode is the default power mode of BMM350 after the chip is powered, Current consumption in suspend mode is minimal, 
   *                               so, this mode is useful for periods when data conversion is not needed. Read and write of all registers is possible.
   *   eBmm350NormalMode       // normal mode  Get geomagnetic data normally.
   *   eBmm350ForcedMode       // forced mode  Single measurement, the sensor restores to suspend mode when the measurement is done.
   *   eBmm350ForcedModeFast  // To reach ODR = 200Hz is only possible by using FM_ FAST.
   */
  bmm350.setOperationMode(eBmm350NormalMode);

  /**
   * Set preset mode, make it easier for users to configure sensor to get geomagnetic data (The default rate for obtaining geomagnetic data is 12.5Hz)
   * presetMode:
   *   BMM350_PRESETMODE_LOWPOWER      // Low power mode, get a fraction of data and take the mean value.
   *   BMM350_PRESETMODE_REGULAR       // Regular mode, get a number of data and take the mean value.
   *   BMM350_PRESETMODE_ENHANCED      // Enhanced mode, get a plenty of data and take the mean value.
   *   BMM350_PRESETMODE_HIGHACCURACY  // High accuracy mode, get a huge number of take and draw the mean value.
   * rate:
   *   BMM350_DATA_RATE_1_5625HZ
   *   BMM350_DATA_RATE_3_125HZ
   *   BMM350_DATA_RATE_6_25HZ
   *   BMM350_DATA_RATE_12_5HZ   (default rate)
   *   BMM350_DATA_RATE_25HZ
   *   BMM350_DATA_RATE_50HZ
   *   BMM350_DATA_RATE_100HZ
   *   BMM350_DATA_RATE_200HZ
   *   BMM350_DATA_RATE_400HZ
   */
  bmm350.setPresetMode(BMM350_PRESETMODE_HIGHACCURACY,BMM350_DATA_RATE_25HZ);


  /**
   * Enable the measurement at x-axis, y-axis and z-axis, default to be enabled, no config required, the geomagnetic data at x, y and z will be inaccurate when disabled.
   * Refer to setMeasurementXYZ() function in the .h file if you want to configure more parameters.
   */
  bmm350.setMeasurementXYZ();
}

void loop()
{
  sBmm350MagData_t magData = bmm350.getGeomagneticData();
  Serial.print("mag x = "); Serial.print(magData.x); Serial.println(" uT");
  Serial.print("mag y = "); Serial.print(magData.y); Serial.println(" uT");
  Serial.print("mag z = "); Serial.print(magData.z); Serial.println(" uT");

  // float type data
  //Serial.print("mag x = "); Serial.print(magData.float_x); Serial.println(" uT");
  //Serial.print("mag y = "); Serial.print(magData.float_y); Serial.println(" uT");
  //Serial.print("mag z = "); Serial.print(magData.float_z); Serial.println(" uT");

  float compassDegree = bmm350.getCompassDegree();
  Serial.print("the angle between the pointing direction and north (counterclockwise) is:");
  Serial.println(compassDegree);
  Serial.println("--------------------------------");
  delay(3000);
}
