taifur20/Edge-Bird/(commit log)

2025-09-30 Hardware files
    Schematic, Gerber, and BOM are added
    [BOM_Details.xlsx, PickAndPlace_Bird-Edge.xlsx]
2025-10-01 sample code for connected peripherals
2025-10-01 sample code for the pressure sensor
2025-10-01 MAX17048 sensor code
2025-10-01 3D design files
    [Bird-Edge-base.stl, Bird-Edge-top.stl, panel_angle.stl, solar_panel_base.stl]
2025-10-05 sample data file
    [data_log.csv]
2025-10-05 Sample code for Neo M8U gps module
2025-10-06 sample gps data
