taifur20/Edge-Bird/3D Files/case.jpg

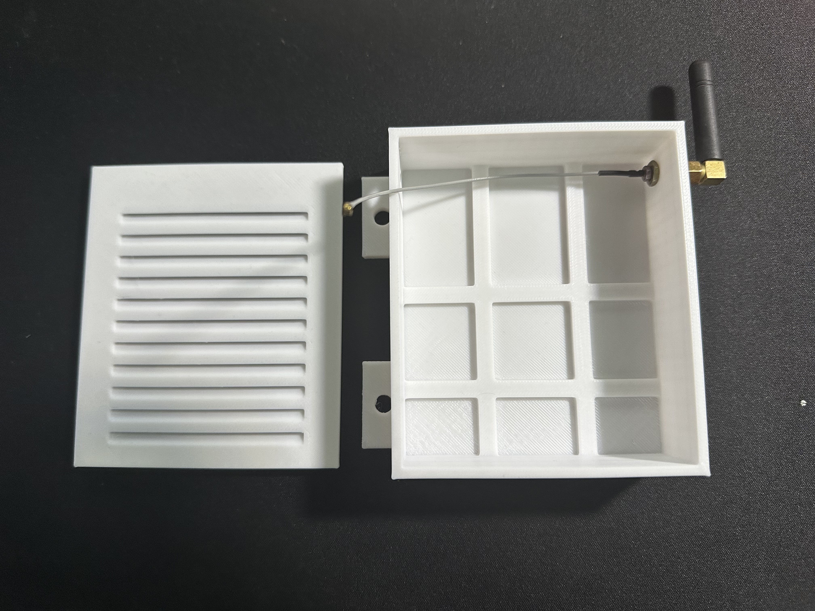
3D Files/case.jpg
